rouming/PLCModem_TDA5051AT/eagle/TDA5051A_DC_LC_PLCModem/TDA5051A_DC_LC_PLCModem.brd

## EAGLE design eagle/TDA5051A_DC_LC_PLCModem/TDA5051A_DC_LC_PLCModem.brd (2019-09-24)

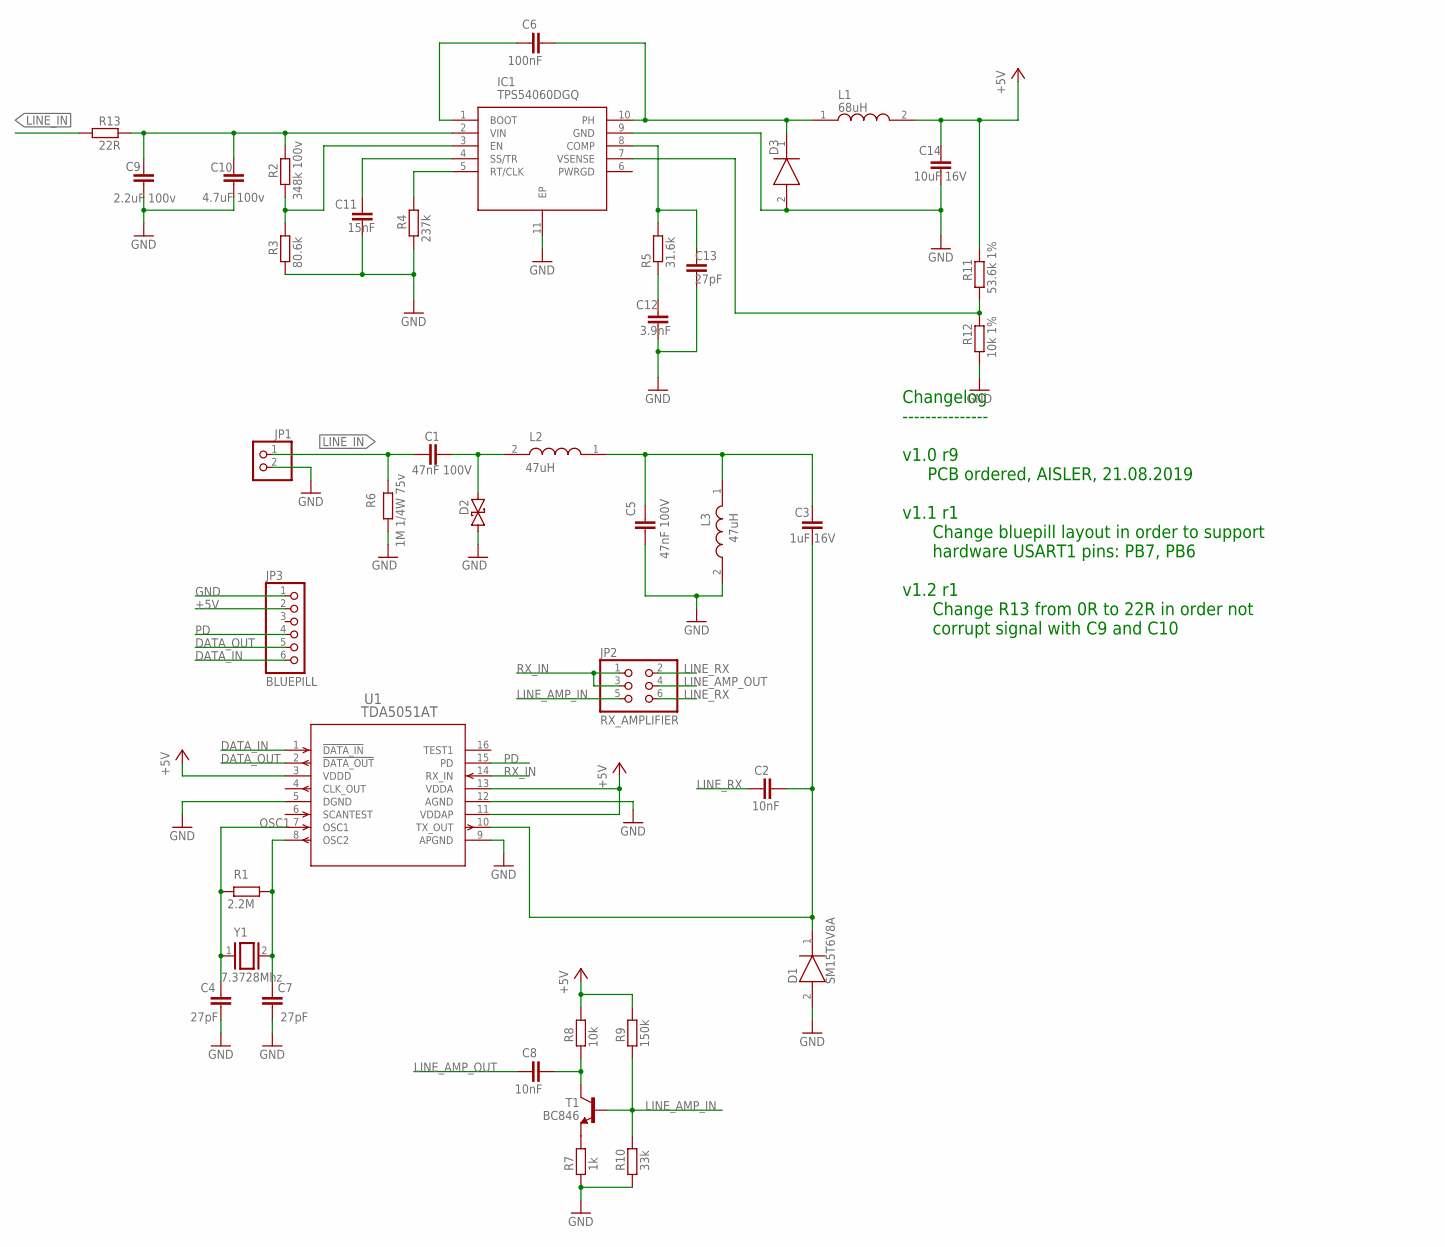
[picture p1: schematic TDA5051A_DC_LC_PLCModem.sch]

Parts:
C1, C5: 47nF 100V; C1206; MPN C1206C473K1RACAUTO
C2, C8: 10nF; C0603; MPN C0603C103K5RACAUTO7411
C3: 1uF 16V; C0805; MPN C0805C105K4RACAUTO
C4, C7, C13: 27pF; C0603; MPN 06035A270JAT2A
C6: 100nF; C0603; MPN C0603C104K5RECAUTO
C9: 2.2uF 100v; C1210; MPN C3225X7R2A225K230AB
C10: 4.7uF 100v; C1210; MPN CGA6M3X7S2A475K200AB
C11: 15nF; C0603; MPN 06035C153KAT2A
C12: 3.9nF; C0603; MPN GCM1885C1H392JA16D
C14: 10uF 16V; C0603; MPN GRM188R61C106KAALD
D1: SM15T6V8A; DIOM8059X265N; MPN SM15T6V8A
D2: SM15T6V8CA; DIOM8059X265N; MPN SM15T6V8CA
D3: STPS2H100A; DIOM5126X265N; MPN STPS2H100A
IC1: TPS54060DGQ; SOP50P490X110-11N; MPN TPS54060DGQR
JP1: PINHD-1X2; 1X02
JP2: RX_AMPLIFIER; 2X03
JP3: BLUEPILL; 1X06; MPN M20-7820646
L1: 68uH; SDR0805-680KL; MPN SDR0805-680KL
L2, L3: 47uH; SDR1307-220ML; MANUFACTURER_PART_NUMBER SDR1307A-470K; MOUSER_PART_NUMBER 652-SDR1307A-470K
R1: 2.2M; R0603; MPN RC0603JR-072M2L
R2: 348k 100v; R0603; MPN RG1608P-3483-D-T5
R3: 80.6k; R0603; MPN CRCW060380K6FKEA
R4: 237k; R0603; MPN AC0603FR-07237KL
R5: 31.6k; R0603; MPN AC0603FR-0731K6L
R6: 1M 1/4W 75v; R0603; MPN RCS06031M00FKEA
R7: 1k; R0603; MPN CRCW06031K00FKEAC
R8: 10k; R0603; MPN CRCW060310K0FKEAC
R9: 150k; R0603; MPN RC0603FR-07150KL
R10: 33k; R0603; MPN RC0603FR-0733KL
R11: 53.6k 1%; R0603; MPN RC0603FR-0753K6L
R12: 10k 1%; R0603; MPN CRCW060310K0FKEAC
R13: 22R; R0603; MPN RC0603JR-070RL
T1: BC846; SOT23; MPN BC846BLT1G
U1: TDA5051AT; SOT162-1; MPN TDA5051AT/C1,518
Y1: 7.3728Mhz; HC/49US_(AT49); MPN ABLS-7.3728MHZ-B2-T

Connections:
+5V: C14.1, JP3.2, L1.2, R8.2, R9.2, R11.2, U1.3 (VDDD), U1.11 (VDDAP), U1.13 (VDDA)
DATA_IN: JP3.6, U1.1 (!DATA_IN)
DATA_OUT: JP3.5, U1.2 (!DATA_OUT)
GND: C4.1, C5.1, C7.1, C9.2, C10.2, C11.2, C12.2, C13.2, C14.2, D1.2 (A), D2.2, D3.2 (A), IC1.9 (GND), IC1.11 (EP), JP1.2, JP3.1, L3.2, R3.1, R4.1, R6.2, R7.1, R10.1, R12.1, U1.5 (DGND), U1.9 (APGND), U1.12 (AGND)
LINE_AMP_IN: JP2.5, R9.1, R10.2, T1.1 (B)
LINE_AMP_OUT: C8.1, JP2.4
LINE_IN: C1.1, JP1.1, R6.1, R13.1
LINE_IN1: C9.1, C10.1, IC1.2 (VIN), R2.2, R13.2
LINE_RX: C2.1, JP2.2, JP2.6
unnamed: C2.2, C3.2, D1.1 (K), U1.10 (TX_OUT)
unnamed: C1.2, D2.1, L2.2
unnamed: C3.1, C5.2, L2.1, L3.1
unnamed: C8.2, R8.1, T1.3 (C)
unnamed: C6.1, IC1.1 (BOOT)
unnamed: C6.2, D3.1 (K), IC1.10 (PH), L1.1
unnamed: R7.2, T1.2 (E)
unnamed: C7.2, R1.2, U1.8 (OSC2), Y1.2
unnamed: IC1.3 (EN), R2.1, R3.2
unnamed: IC1.5 (RT/CLK), R4.2
unnamed: C11.1, IC1.4 (SS/TR)
unnamed: C12.1, R5.1
unnamed: C13.1, IC1.8 (COMP), R5.2
unnamed: IC1.7 (VSENSE), R11.1, R12.2
OSC1: C4.2, R1.1, U1.7 (OSC1), Y1.1
PD: JP3.4, U1.15 (PD)
RX_IN: JP2.1, JP2.3, U1.14 (RX_IN)
TEST1: U1.16 (TEST1)

Notes on the sheet:
Changelog --------------- v1.0 r9 PCB ordered, AISLER, 21.08.2019 v1.1 r1 Change bluepill layout in order to support hardware USART1 pins: PB7, PB6 v1.2 r1 Change R13 from 0R to 22R in order not corrupt signal with C9 and C10

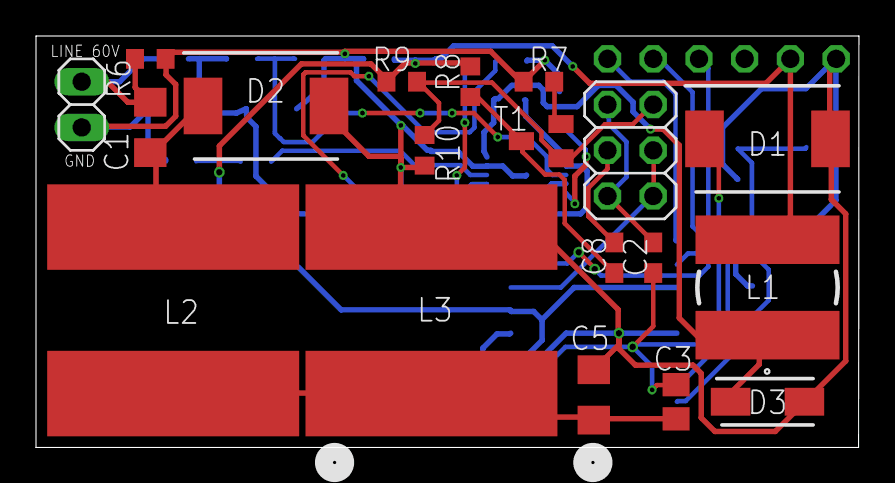
[picture p2: board TDA5051A_DC_LC_PLCModem.brd from above]

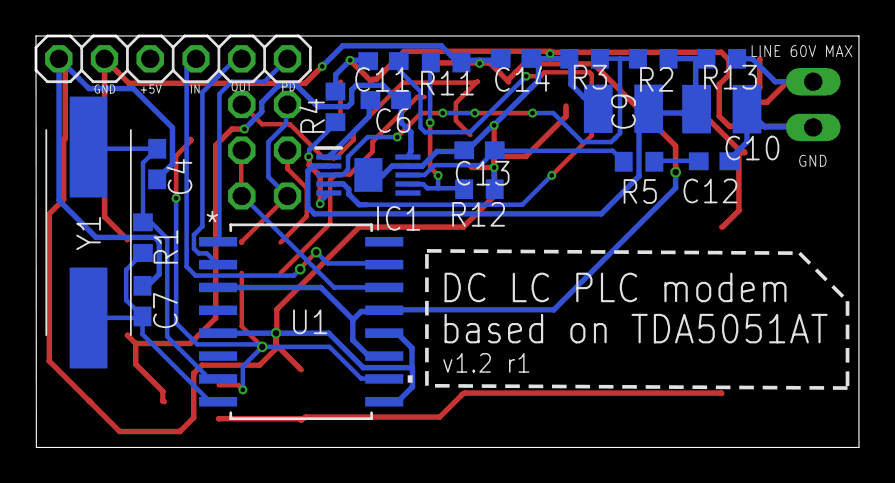
[picture p3: board TDA5051A_DC_LC_PLCModem.brd from below]

Board: 2 copper layers, 45.7 x 22.9 mm, 40 parts (21 on the bottom side), 26 nets.
