rouming/PLCModem_TDA5051AT/firmware/Src/main.c

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

/* Includes ------------------------------------------------------------------*/
#include "main.h"

/* USER CODE BEGIN Includes */
#include "usart.h"
/* USER CODE END Includes */

UART_HandleTypeDef huart1;

void SystemClock_Config(void);
static void MX_GPIO_Init(void);
static void MX_USART1_UART_Init(void);
/* USER CODE BEGIN 0 */

struct pkt {
	uint32_t seq;
};

struct ctx {
	struct pkt pkt;
	uint32_t seq;
	uint32_t seq_inited;
};

static int handle_request(void *ctx_, uint8_t rx_len,
			  void **tx_buf_out, uint8_t *tx_len_out)
{
	struct ctx *ctx = ctx_;

	if (rx_len != sizeof(ctx->pkt))
		/* Wrong length */
		return -1;

	if (ctx->seq_inited) {
		int correct_seq = (ctx->seq + 1 == ctx->pkt.seq);

		if (!correct_seq) {
			ctx->seq_inited = 0;
			return -1;
		}
	}
	ctx->seq = ctx->pkt.seq;
	ctx->seq_inited = 1;

	*tx_buf_out = (uint8_t *)&ctx->pkt;
	*tx_len_out = sizeof(ctx->pkt);

	return 0;
}

static int handle_response(void *ctx_, uint8_t rx_len)
{
	struct ctx *ctx = ctx_;

	if (rx_len != sizeof(ctx->pkt))
		/* Wrong length */
		return -1;

	return (ctx->seq == ctx->pkt.seq ? 0 : -1);
}


/* USER CODE END 0 */

/**
  * @brief  The application entry point.
  * @retval int
  */
int main(void)
{
  /* USER CODE BEGIN 1 */
  struct ctx ctx = {
	  .seq = 0,
  };
  /* USER CODE END 1 */

  /* MCU Configuration--------------------------------------------------------*/

  /* Reset of all peripherals, Initializes the Flash interface and the Systick. */
  HAL_Init();

  /* Configure the system clock */
  SystemClock_Config();

  /* Initialize all configured peripherals */
  MX_GPIO_Init();
  MX_USART1_UART_Init();
  /* USER CODE BEGIN 2 */
  USART_Init(&huart1);

  /* Power down to LOW */
  HAL_GPIO_WritePin(GPIOB, PD_Pin, GPIO_PIN_RESET);
  HAL_Delay(10);
  /* USER CODE END 2 */

  /* Infinite loop */
  /* USER CODE BEGIN WHILE */
  while (1) {
	  int ret;

	  if (HAL_GPIO_ReadPin(GPIOB, MASTER_LINK_Pin)) {
		  /* Master */
		  ctx.pkt.seq = ++ctx.seq;

		  ret = USART_SendRecvSync(&ctx.pkt, sizeof(ctx.pkt), /* tx */
					   &ctx.pkt, sizeof(ctx.pkt), /* rx */
					   REPEAT_TX_REQS_x5);
		  if (ret >= 0)
			  ret = handle_response(&ctx, ret);
	  } else {
		  /* Slave */

		  ret = USART_RecvSendSync(&ctx,
					   &ctx.pkt, sizeof(ctx.pkt), /* rx */
					   handle_request);
	  }

	  if (!ret) {
		  HAL_GPIO_WritePin(GPIOC, BP_LED_Pin, GPIO_PIN_RESET);
		  HAL_Delay(10);
		  HAL_GPIO_WritePin(GPIOC, BP_LED_Pin, GPIO_PIN_SET);
		  HAL_Delay(10);
	  }

	  USART_Process();
    /* USER CODE END WHILE */

    /* USER CODE BEGIN 3 */
  }
  /* USER CODE END 3 */
}

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
