rouming/PLCModem_TDA5051AT/firmware/PLCModem_TDA5051AT.ioc

Mcu.UserName=STM32F103C8Tx
PA13.Signal=SYS_JTMS-SWDIO
PA14.Signal=SYS_JTCK-SWCLK
PB2.GPIO_Label=MASTER_LINK
PB2.Signal=GPIO_Input
PB6.Signal=USART1_TX
PB7.Signal=USART1_RX
PB8.GPIO_Label=PD
PB8.Signal=GPIO_Output
PC13-TAMPER-RTC.GPIO_Label=BP_LED
PC13-TAMPER-RTC.Signal=GPIO_Output
PD0-OSC_IN.Signal=RCC_OSC_IN
PD1-OSC_OUT.Signal=RCC_OSC_OUT
