rouming/PLCModem_TDA5051AT/firmware/Inc/main.h

#define BP_LED_Pin GPIO_PIN_13
#define BP_LED_GPIO_Port GPIOC
#define MASTER_LINK_Pin GPIO_PIN_2
#define MASTER_LINK_GPIO_Port GPIOB
#define PD_Pin GPIO_PIN_8
#define PD_GPIO_Port GPIOB
