rouming/PLCModem_TDA5051AT/(commit log)

2019-09-24 Add EAGLE schematics and board
    [TDA5051A_DC_LC_PLCModem.brd, TDA5051A_DC_LC_PLCModem.sch]
2019-10-06 firmware: fix sequence check
    Reinit local sequence value if slave does not receive a valid
    sequence from a master.
    [main.c]
